paulsilvis/DustCollector/README.md

# DustCollector
restarting this project from scratch with new directory structure
