paulsilvis/DustCollector/obsidian-vault/To-Do List.md

(started 6/2/2025, since we're getting near the end)
	
	- ~~add the dust-level sensor for the collector bin to the doc~~
	- make that sensor and install it
	- make the rest of the blast gates
		- install the limit switches
	- fix the blast gate that's bent
	- install the remaining ductwork and blast gates
	- do the wiring
	- install the current sensors
	- ready the enclosure for wiring
		- mark and cut db-25 openings
		- make mounts for fuses
		- add reboot / shutdown switch
		- replace emergency shutoff switch
	- ~~have a beer~~
	- 
	-
