paulsilvis/DustCollector/docs/temp.md

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

<!-- vscode-markdown-toc-config
	numbering=true
	autoSave=true
	/vscode-markdown-toc-config -->
<!-- /vscode-markdown-toc -->

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

As  I  put  together  a  plan  for  salvaging  some  parts  of  the  original  collector  and  upgrading  my  filtering  capacity,  I  decided  that  it  would  be  really  _cool_  to  do  just  a  bit  more  automation,  and  have  the  blast  gates  operate  automatically  depending  on  what  tools  (e.g.,  tablesaw,  drillpress)  were  running.

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

###  1.1. Essential  Goals

So,  the  _essential_  goals  areh>:

-  Open  and  close  appropriate  blast  gates  automatically  when  any  powered  tool  is  running,  and  close  them  when  none  are  running.

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

-  The  entire  controller  must  fit  inside  a  wall-mounted  enclosure  with  a  clear  door  for  visibility.

###  1.2. Optional  Goals

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

##  2. The  Big  Picture  --  Physical  System
The  physical  system  consists  of:
-  the  recycled  impeller,  housing  and  motor  from  the  original  dust  collection  system.
-  a  'Dust  Deputy'  cyclone  to  direct  most  of  the  heavy  debris  downwards  to  ...
-  a  collection  bin  with  a  capacity  of  <tbc>  cubit  feet
-  a  heavy  duty  pleated  commercial  filter  rated  MERV  14  that  catches  particles  as  small  as  1.5  microns,  which  sits  atop...
-  a  removable  bucket  fastened  securely  to  it  that  holds  dust  released  from  cleaning  the  filter  by  banging  on  it  **gently**  while  dousing  it  with  **low-pressure**  compressed  air  from  the  outside.

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

The  [canister  filter](https://wynnenv.com/?s=13F230NANO+&post_type=product)  is  from  Wynn  Environmental,  and  costs  about  $230.  This  high-efficiency  filter  traps  over  95%  of  particles  sized  3.0-10.0  microns,  such  as  lint,  dust,  pollen,  pet  dander,  and  mold  spores,  as  well  as  particles  from  coughs,  sneezes,  and  smog.    Here's  a  [filter  rating  chart](https://www.mechreps.com/PDF/Merv_Rating_Chart.pdf)  to  give  you  more  information.

At  the  botom  of  the  filter  a  collection  bucket  is  attached  with  a  "gamma  seal"  lid  --  it  just  twists  off.

alt text

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

##  3. Project  Directory  Structure

        ├──  docs
        │    └──  images
        ├──  hardware
        ├──  notebooks
        ├──  obsidian-vault
        ├──  src
        │    ├──  dustcollector
        │    └──  hardware
        └──  tests

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

-  The  'notebooks'  directory  is  intended  for  [jupyter](https://jupyter.org/)  things  like  experiments,  informal  tests,  etc.

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

##  4. Software  Architecture

a picture

##  5. Key  Subsystems

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

The  main  tools  are:
-  the  table  saw
-  the  lathe
-  the  drill  press

Each  of  these  has  a  5-inch  duct  connecting  it  to  the  intake  of  the  dust  collector.    At  some  point  on  the  ductwork  leading  to  each  tool  there  is  a  blast  gate  that  controls  the  flow  of  air  into  the  dust  collector.

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

####  5.1.1. The  Distributor

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

[Yes,  this  is  excessive.    I  don't  care.    I  like  lots  of  switches  and  buttons.]

###  5.3. The  Current  Sense  Subsystem
The  'on'  or  'off'  state  of  a  given  power  tool  such  as  the  table  saw  is  determined  by  detecting  the  presence  or  absence  of  current  in  a  split-coil  transformer  wrapped  around  the  'hot'  line  going  to  the  saw.    This  is  connected  to  a  custom  circuit  on  the  controller  that  converts  the  0  -  100  mA  current  into  a  0-5V  signal  to  be  read  by  an  a/d  converter  and  converted  to  a  logic  value  meaning  'on'  or  'off'.

###  5.4. The  Gate  Control  Subsystem
The  gate  conrol  system  is  responsible  for  sensing  machine  state  (On  or  Off),  opening/closing  the  appropriate  blast  gate[s]  and  turning  on  (or  off)  the  dust  collector  impeller  motor.

Gate States

There  is  currently  a  provision  for  a  delay  before  turning  off  all  tools  and  turning  off  the  dust  collector  impeller  motor.    This  is  to  allow  any  remaining  dust  to  be  sucked  out  of  the  system.    It  may  turn  out  that  this  is  unnecessary  due  to  the  high  velocity  of  the  air  in  the  ducts  (estimated  to  be  over  80  MPH).

##  6. The  Top  Level  Software  Structure

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

[^Bob]:  This  is  the  name  I  gave  to  my  ChatGPT  agent.   We're  good  friends  now.]

##  7. Enclosure

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

##  8. The  Monitor  Subsystem

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

##  9. Wiring

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

1.  Length  considerations
2.  Connector  type  mismatches
3.  Connector  pin  assignments  don't  match.

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

A/C:
        Neutral  --  White  (referred  to  as  Gnd  on  the  board)
        Hot  --  Black
        Ground  --  Green.

D/C:
        5V  --  Orange
        3.3V  --  Black
        12V  --  Red
        Gnd  --  White

All  Ground  connections  are  tied  together  on  the  board.

____Remember  --  this  is  not  guaranteed!      Look  at  where  the  wires  go  to  be  sure.____

###  9.1. The Current Sense Circuit

This custom circuit board holds 4 identical circuits to convert a 0-100 mA current from a transformer into a small voltage that a 4-channel ADS1115 a/d converter can read.

<TBD> Need a circuit diagram here.

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

<TBD> Need a circuit diagram here.

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

#####  74HC595  Chaining  and  Bit-to-Pin  Mapping

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

#####  Critical  Fact  About  Chained  595s:

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

Thus:
-  byte1  →  chip2
-  byte2  →  chip1

Bit-to-Pin  Layout  (directly  from  the  code)

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

In  Practical  Summary:
---------------------
-  byte1  →  fills  chip2  (the  far  one)
-  byte2  →  fills  chip1  (the  near  one)
-  Pins  1-6  on  each  chip  will  reflect  bits  1-6  of  each  respective  byte.
-  MSB  (bit  7)  and  LSB  (bit  0)  could  be  unused  or  reserved.

Visual  Sketch:
--------------
SPI  -->  [byte2][byte1]
                  |            |
                  |            +-->  chip2  (pins  1-6)
                  +-------->  chip1  (pins  1-6)

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

**Final  Word:**

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

----------------------------------------

#####    The  Net  Result

This  organization  means  that  it  is  easy  to  spot  the  3  signals  need  for  each  motor.    Take  a  look  at  the  circuit  board  and  you'll  s        """ee  that  E(enable),  S(step)  and  D(dir)  are  grouped  for  each  motor.    Look  at  the  two  shift-register  chips.  For  chip  1  (left)  pins  1,  2  and  3  are  ESD  for  motor  4  (the  nearest  motor.  For  chip  2  (right)  pins  4,  5  and  6  are  ESD  for  Motor  1  (the  nearest  motor).    You  get  the  idea.  Cool.

##  10. Power  Supplies

I  decided  not  to  use  the  Raspberry  Pi  4b  plug-in  power  input  for  these  reasons:

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

-  [12V  supply]  (https://www.amazon.com/dp/B00M8TBJLK?ref_=ppx_hzsearch_conn_dt_b_fed_asin_title_6)  

        Description:  LRS-150-12  150W  12V  12.5  Amp  Enclosed  Switchable  Power  Supply  

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

##  11. Digital  I/O  Pin  Map

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

###  12.1. Stepper  Drivers

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

**Safe  VREF  Setup  Without  Motor  Connected  (Courtesy  of  Bob)**

**Purpose:**

        Prevents  the  chance  of  slamming  full  current  into  the  motor  during  first  power-up.

        Avoids  a  damaged  motor,  a  fried  driver,  or  accidental  runaway  heating.
        
**Steps:**

        Install  the  new  DRV8825  board,  BUT  DO  NOT  connect  the  motor  coils  yet.

                Leave  the  motor  wiring  unplugged.

                Only  connect  logic  (VDD,  GND,  STEP,  DIR,  ENABLE)  and  motor  power  (VMOT,  GND).

        Power  up  the  system  (logic  and  VMOT  live).

        Measure  VREF  at  the  trimpot  just  like  before:

                Black  multimeter  probe  to  GND.

                Red  probe  to  the  metal  top  of  the  potentiometer.

        Adjust  VREF  carefully:

                Clockwise  to  increase,  counterclockwise  to  decrease.

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

        Power  down  the  system.

        Connect  the  motor  coils  properly:

                Double-check  you  know  which  motor  wire  pairs  are  each  coil.

                (If  not  sure,  I  can  give  you  a  10-second  multimeter  method.)

        Power  back  up  and  test  the  motor  gently  (slow  step  pulses  first).

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

###  12.2. Power  Supplies

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

<TBD> MENTION THEM!

###  13.2. Coding

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

The style guide is:

- pycodestyle compliant
- flake8 compliant
- black -l 79 compliant

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

###  13.3. A Note on Using AI to Generate Code

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
