paulsilvis/DustCollector/docs/design-doc.odt

Dust Collector System

Design Document

This will add linear actuators (or maybe rotary servo motors) to new custom-made (or possibly commercial-off-the-shelf) blast gates, plus sensors to detect when a machine is turned on or off to control blast gates and the dust collector motor appropriately.

Disclaimer: I know that this whole thing could be done without a microprocessor by a clever hardware engineer who knew his trade. It would be cheaper by far, and cooler by an order of magnitude. I am not such a person, however, so I revert to my safe zone as a software engineer and crush this problem with a dedicated computer running a Python program on a Linux machine. So there.

# Be sure to check the ‘new ideas’ section at the end.

### Architecture

This picture is an overall view of the physical collection system:

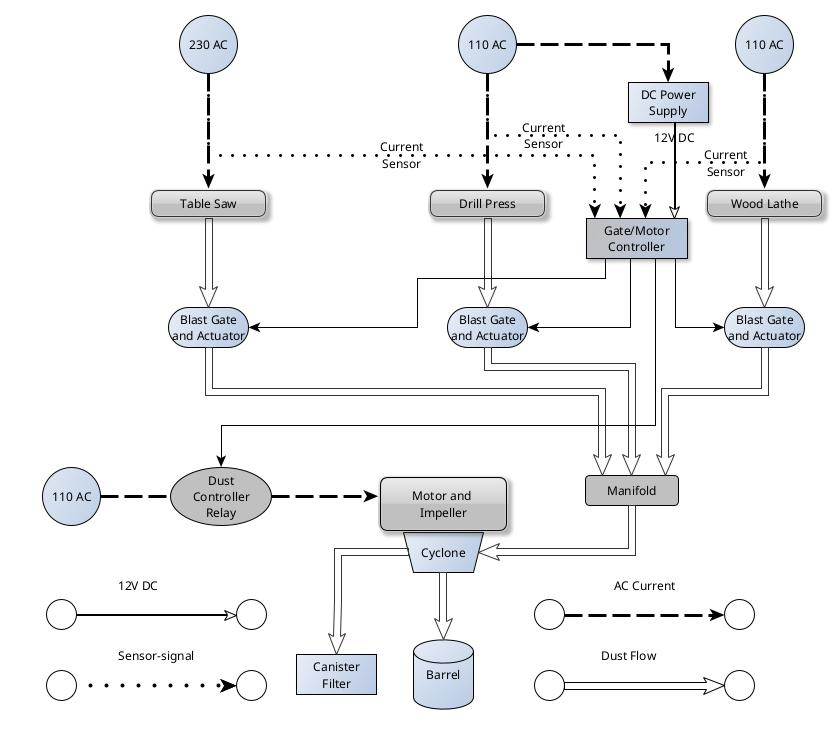
[picture p7: figure]
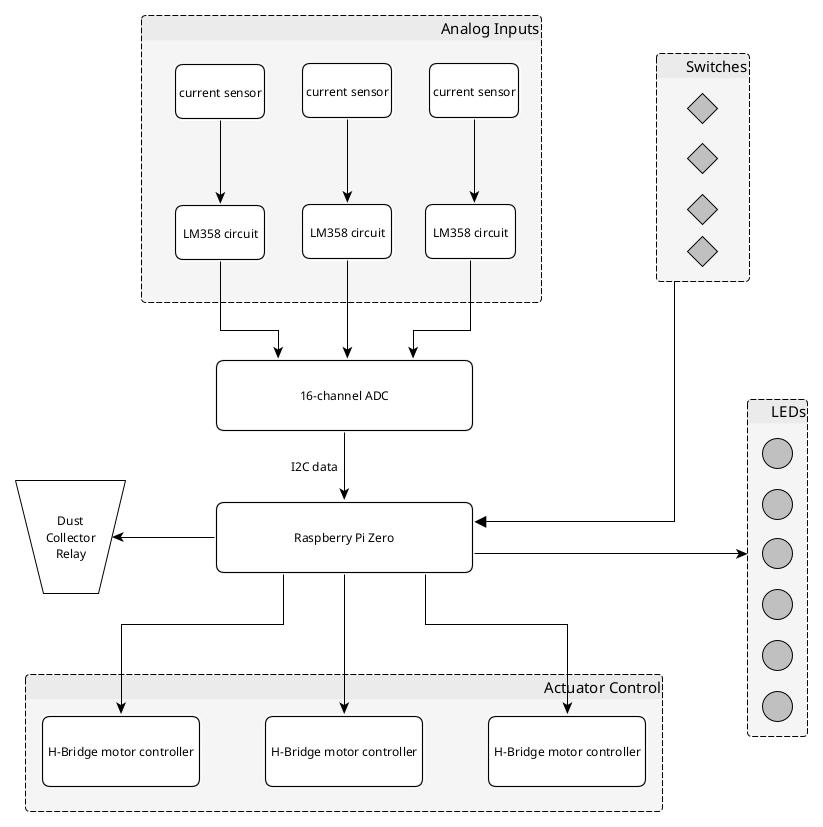
[picture p8: figure]

This is an overview of the hardware system (the controller itself):

# Gate/Motor Controller

This controller is implemented on a Raspberry pi zero, much like this one (https://www.adafruit.com/product/3708) by adafruit. I’ve got plenty of suitable wall-plug 5V supplies like this one (https://www.adafruit.com/product/1995) available, so one of them will do for power. It’s got more than enough GPIO for my needs. I’ll need an external A/D multi-channel converter such as this ADS1115 (https://how2electronics.com/how-to-use-ads1115-16-bit-adc-module-with-arduino/) for sensing current in the shop tools (saw, drill press and lathe power cords).

### Components

I have on order from Amazon:

1. A linear actuator that travels 4 inches in a couple of seconds, and has a 4.5 lb push, which should be more than enough. See this information (https://www.amazon.com/dp/B07ZJ46947?ref=ppx_yo2ov_dt_b_fed_asin_title&th=1).
2. A 12V power supply for the actuator. This one can handle power needs for all 3 gates. See this information (https://www.amazon.com/dp/B00M8TBJLK?ref=ppx_yo2ov_dt_b_fed_asin_title).
3. A current sensor module. See this information (https://www.amazon.com/dp/B0C6Y5MJNM?ref=ppx_yo2ov_dt_b_fed_asin_title).
4. A 40 Amp AC solid state relay to control power to the dust collector motor. See this information. (https://www.amazon.com/dp/B07L1MKFG6?ref=ppx_yo2ov_dt_b_fed_asin_title)
5. 1 pc. 47 Ohm resistor from Amazon (100)
6. 2 pcs. 10K Ohm resistors from Amazon (100)
7. LM358 op amp and block from Amazon (lots)
8. 16 bit 4- channel ADC from Amazon (https://www.amazon.com/gp/product/B0CNV9G4K1/ref=ox_sc_act_title_2?smid=A38CU2XC1RY0BO&psc=1) (3 pcs) (spec sheet here (https://www.ti.com/lit/ds/symlink/ads1115.pdf?ts=1736820696729)) There is a good library built for this -- see here (https://github.com/ncdcommunity/Raspberry_Pi_ADS1115_16Bit_4Channel_ADC_Python_Library/blob/master/ADS1115.py).
9. H-Bridge motor controller from Amazon (https://www.amazon.com/gp/product/B0C5JCF5RS/ref=ox_sc_act_title_1?smid=A2RFXKS6GNXFWP&psc=1) (4 pcs) (spec sheet here (https://www.handsontec.com/dataspecs/L298N%20Motor%20Driver.pdf)) Some usage notes: here (https://howtomechatronics.com/tutorials/arduino/arduino-dc-motor-control-tutorial-l298n-pwm-h-bridge/) (there may be confusion between different specs – be sure to follow the actual labels on the board)
10. I will soon order this canister filter (https://wynnenv.com/products-page/cyclone-filter-pricing/13r230nano/) that is MERV 15, Open Both Ends, 34" Tall, No Inner cage - Heavy duty outer cage. I have 84 inches of height to work with. If I stack two of them, that takes up 68 inches, leaving me with 16 inches to spare. That does not leave me room for both the inlet above and a bucket below. About $225
11. If I have a bucket below the filter for catching stuff, I need a gamma lid (https://www.amazon.com/s?k=gamma+lid). Here’s a link to a youtube video that shows how to mount it (https://youtu.be/HYTR24EQ8hI). About $12. (https://www.amazon.com/Oneida-Air-Systems-Super-Deputy/dp/B09WWM6X3F?mcid=15b9428ab17b326db8282fca8c1c037e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)
12. I will also order a Dust Deputy Cyclone (https://www.amazon.com/Oneida-Air-Systems-Super-Deputy/dp/B09WWM6X3F?mcid=15b9428ab17b326db8282fca8c1c037e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) from Amazon. About $180.

Items 5, 6 and 7 form a circuit to read the current signal coming from the current sensor (item 3).

Item 8 connects all 3 analog inputs from each of the converters made by 5-7 and convert them to digital.

Item 9 controls the linear actuators (reverse/forward)

### Basic Logic

The controller measures the current sensor on each machine. If there is current flowing (that is, the machine is on) then the blast gate for that machine is opened. [Since the actuator has limit switches at each end, it should OK to keep telling it to open. Otherwise some sort of state machine is in order.] In addition, the relay for the dust collector motor is activated, turning on the dust collector. [This too is an idempotent operation.] If a sensor indicates that the machine is not running (no current) then the corresponding blast gate is closed [again, idempotent]. If no machines are running, the dust collector relay is turned off, and the dust collector stops after a suitable delay (maybe 3 minutes or so? Maybe determined by dip switches? Or overridden by push-button?)

There may be a need to introduce a short delay between starting to open the blast gate and turning on the dust collector, since the actuator needs a couple of seconds to work. This is easy to do if it becomes necessary, but I don’t think it will – it takes the dust collector motor a couple of seconds to spin up anyways, and that’s about how long it takes the gate to open.

I should include some power-on logic in the program to move each output to a known safe state (gates closed, dust collector off) and wait for a second or two.

At this time I don’t see the need to provide micro-switches to detect open/closed gates, but that’s a possibility if I want to detect faults in the system such as a jammed gate or burned-out actuator or servo.

### Input and Outputs

#### Inputs

The 16-bit 4-channel ADC is an I2C device. The circuit diagram is shown below.

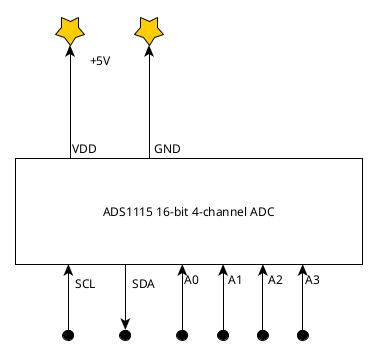
[picture p9: figure]

The input from the current sensors is an analog voltage I can read with the multi-channel A/D after running it through the LM358 circuit. The circuit below (from a youtube screenshot (https://youtu.be/tA5pcc-xyJg?t=98)) will measure current in the PCTZ-02.

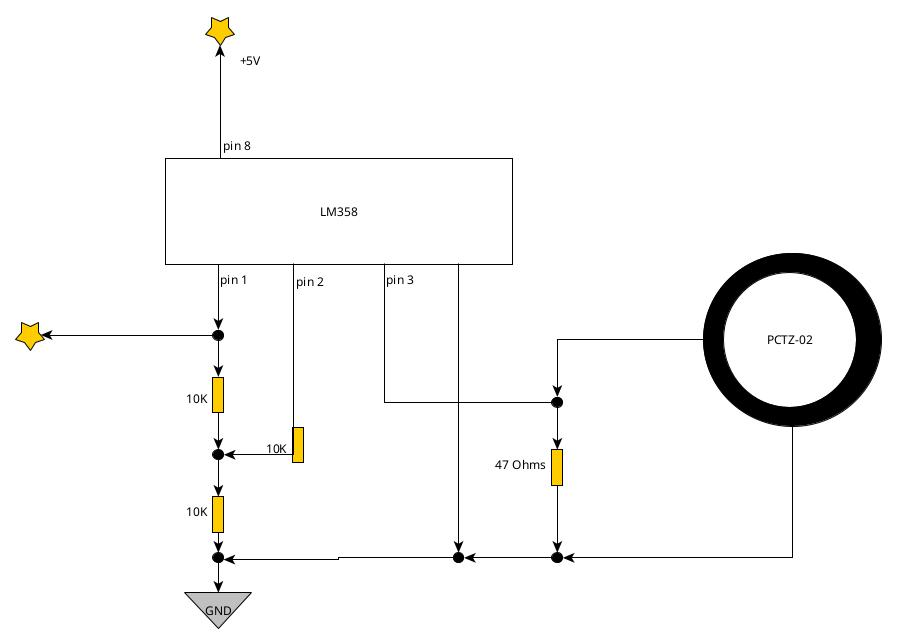
[picture p10: figure]

### Outputs

- Output to the actuators is just a 12-volt signal with polarity reversed to reverse the direction. Here’s a link to a ChatGPT discussion about H-bridges (https://chatgpt.com/share/6785ed26-9738-8001-8c28-717485e1faa6) to implement this.
- Output to the solid-state relay is simple.
- I might want to add some LED outputs to show status, just for coolness. For example, green for open, red for closed, similar for the motor.

### Hardware

There are many designs for blast gates, such as this one (https://www.etsy.com/listing/1199263512/blastgate-gate-valve-gate-valve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) for DIY, or this one (https://www.etsy.com/listing/1778996941/4-motorized-blast-door-for-dust?gpla=1&gao=1&gad_source=1) (which is really silly, because it would leak like a sieve) , or this beauty (https://www.etsy.com/listing/1684678449/dust-collection-blast-gate-clog-free?external=1&rec_type=ad&frs=1) (with free shipping – this is the best one I’ve seen.). Then there’s this plan (https://www.etsy.com/listing/1043535705/blast-gates-for-dust-extractor-svg-dxf?click_sum=d91ce4a6) for DIY – very cool. If the servo I just ordered doesn’t do the trick, this one surely will (https://www.amazon.com/ZOSKAY-DS3218-Digital-Waterproof-Control/dp/B01MU7TQV8).

### Testinghere

Just for coolness it would be neat to add a push-button that would initiate a sequence of events to verify correct operation. (There’s lots of great choices for momentary contact panel-mount push-buttons like these (https://www.amazon.com/DMWD-12-Pack-Momentary-Pre-soldered-PBS-110/dp/B0BHC5RXY1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). De-bouncing: look here (https://raspberrypi.stackexchange.com/questions/118349/what-is-the-proper-way-to-debounce-a-gpio-input) for a hardware solution, or here (https://hackaday.com/2010/11/09/debounce-code-one-post-to-rule-them-all/) for software solutions)

For example, one such sequence would be:

1. open gate 1, wait 5 seconds,
2. close gate 1, wait 5 seconds
3. same for gates 2 and 3
4. open all gates, wait for 5 seconds
5. close all gates, wait 5 seconds
6. open all gates, wait 5 seconds
7. turn on dust collector, wait 60 seconds
8. turn off dust collector
9. close all gates

… and so on.

### Online Resources

- measuring ac current with arduino (https://www.youtube.com/watch?v=tA5pcc-xyJg)

### Development methodology

Python is the language of choice here. ChatGPT can do a decent job of generating skeleton code given suitable prompts. I plan to develop separate Python apps for checking out each component.

- Current sensor input: a program to read the current sensor at 1 Hz or so and print out the value.
- Linear actuator: a program to move the actuator all the way out, wait 3 seconds, then all the way back, wait 3 seconds, and repeat.
- Solid-state relay: turn AC outlet on and off.
- Basic logic: a program that will exercise the logic of the controller by simulating inputs via a script. Doing this early on will make implementation of the logic easier.

## New Ideas

This guy (https://www.digikey.com/en/maker/projects/diy-dust-collection-automation-smart-blast-gates-with-home-assistant/6c950d28854840119afbce4b54b79a19) has a nice way of moving blast gates. So does this guy (http://www.shigshop.com/blast-gate-plans.html). The idea is to use a blast gate that pivots around a single point instead of sliding linearly. I’ve ordered 3 servo motors (https://www.amazon.com/dp/B0BKPL2Y21?smid=A1YZW40LYQY3L1&ref_=chk_typ_imgToDp&th=1) from Amazon that I’ll play with – this might be a more compact solution.

Also, I may need a small fan to keep air running over the processor board to keep it from overheating.

I may need a hardware switch to force each gate/collector control, if I want to just run the dust collector without having a machine on (to clear the air in the shop, for example). Also need to disable the controller from running its usual loop. Or, read both the current and the switch and ‘or’ them together?

This phenolic (https://www.amazon.com/Leecraft-BK-2-Blank-Phenolic-Sheet/dp/B0002898CQ?cv_ct_cx=phenolic+sheet+1%2F4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) would be good for blast gate material, housed in an MDF enclosure.

This sensor (https://www.amazon.com/dp/B091XXY98J?s=industrial&sp_csd=d2lkZ2V0TmFtZT1zcF9kZXRhaWw) may be a better choice for measuring the current. Code is here (https://www.electroniclinic.com/measure-current-with-arduino-split-core-current-transformer-ct/).

I had a good chat with ChatGPT about servos – the results are in the files “full_verbatim_servo_chat_final_corrected.pdf” and “servo_power_up_chat_cleaned.pdf”.

McMaster-Carr (https://www.mcmaster.com/products/blocks/material~polycarbonate/impact-resistant-polycarbonate-sheets/) is a good source of thick sheets of polycarbonate, Delrin and such for making mounting blocks for the servos to glue on to the gate housing. Will 15-minute J-B Weld hold Delrin? (answer: not very well)

### Wish List

1. Nice GUI touch display
  1. graphs showing history of particulate matter in the air
  2. animated gate states and blower states
  3. temp, humidity ambient
  4. temp/humidity inside enclosure
  5. temp of raspberry pi
  6. current time and date in different zones
  7. shopcam
  8. Foxnews

differential pressure sensor (https://www.aliexpress.us/item/3256802384784556.html?src=google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)

another one (https://www.aliexpress.us/item/3256802384784556.html?src=google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)

enclosure (https://www.amazon.com/KWONONG-Enclosure-Waterproof-Electrical-350×250×150mm/dp/B0BWR3LG6C?sbo=RZvfv%2F%2FHxDF%2BO5021pAnSA%3D%3D) or this (https://www.amazon.com/Otdorpatio-Waterproof-Electrical-Electronic-Enclosure/dp/B0D8JQPGSX?s=industrial) or this (https://www.amazon.com/QILIPSU-Waterproof-Electrical-Enclosure-Weatherproof/dp/B0C99F7Q5X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)

this will also work (https://www.amazon.com/QILIPSU-Waterproof-Electrical-Enclosure-Weatherproof/dp/B0C99F7Q5X?s=industrial)

shopcam! (https://www.instructables.com/How-to-Make-Raspberry-Pi-Webcam-Server-and-Stream-/)
