paulsilvis/DustCollector/docs/development-notes.odt

Notes on Development

## Miscellaneous

1. Clean up the office so I can get at the embedded system development stuff.
2. Get that out and inventory it to see if I’ve already got a Raspberry pi that will suffice.
3. If so, use it, if not, get one.
4. Learn how to use its wireless capability
5. Clean up the shop so I can use the end of the workbench as a work area for laptop and Raspberry pi development.
6. I checked out the linear actuator, should have no problem using that, although servo operation will be cooler with a wedge gate.
7. Wow – maybe I could use a Raspberry Pi pico W. This shit is incredible.
8. Fan for ambient filter: https://www.amazon.com/Air-King-9723-20-Inch-3-Speed/dp/B0007Q3RMA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
9. filter for ambient filter:https://www.amazon.com/Nordic-Pure-20x20x1-Pleated-20x20x1M14-6/dp/B007KPY8DI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
10. improve performance of corsi-rosenthal filter: https://www.texairfilters.com/how-to-improve-the-efficiency-of-the-box-fan-and-merv-13-filter-air-cleaner/
11. another, more powerful fan: https://www.amazon.com/dp/B000GGNTU6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 (https://www.amazon.com/dp/B000GGNTU6?s=home-garden&sp_csd=d2lkZ2V0TmFtZT1zcF9kZXRhaWxfdGhlbWF0aWM)
12. particulate matter sensor: https://www.amazon.com/dp/B08DP2HBPN (very cool)
13. standoffs for mounting: https://www.amazon.com/dp/B0CBPGKDP4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 (https://www.amazon.com/dp/B0CBPGKDP4?s=industrial&sp_csd=d2lkZ2V0TmFtZT1zcF9kZXRhaWw)
14. breakout board for rpi: https://www.amazon.com/Status-Terminal-Block-Breakout-Raspberry/dp/B08RDYDG6X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
15. case for rpi?: https://datasheets.raspberrypi.com/case/case-for-raspberry-pi-5-product-brief.pdf
16. rpi4 case?: https://www.amazon.com/Miuzei-Raspberry-HDMI-Micro-Aluminum-Included/dp/B07VX2WDHM
17. hdmi mountable connector: https://www.amazon.com/Toronce-Panel-Mount-Connector-D-HDMI-Through/dp/B092W917NG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
18. mountable usb port: https://www.amazon.com/BATIGE-Square-Extension-Motorcycle-Dashboard/dp/B0BDWV1BCV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
