paulsilvis/DustCollector/docs/interfaces.odt

This document lists the various interfaces and provides some detail about them.

## Break Beam Interface

This is pretty simple. (https://www.amazon.com/dp/B00XW2NVJU?ref=ppx_yo2ov_dt_b_fed_asin_title) (but won’t work for me…) This one is better and is on order. (https://www.amazon.com/dp/B09L63KPZS?psc=1&smid=A3HMB6GLG0WJ17&ref_=chk_typ_imgToDp) datasheet here (https://www.ett.co.th/productSensor/E3F-5DP1-5L/Manual%20of%20Photo-SensorSW%20M18-E3F.pdf)

## PIR Sensor Interface

<tbd>

## Switch Interface

This will probably use a digital mux like this. (https://www.amazon.com/gp/product/B07P2H1NZG/ref=ppx_yo_dt_b_asin_title_o02_s00?ie=UTF8&psc=1) Datasheet here. (https://www.waveshare.com/wiki/MCP23017_IO_Expansion_Board)

## Multichannel ADC Interface

This will make things easier. (https://www.amazon.com/gp/product/B0CNV9G4K1/ref=ppx_yo_dt_b_search_asin_title?ie=UTF8&psc=1) Datasheet here. (https://cdn-shop.adafruit.com/datasheets/ads1115.pdf)

## Servo Driver Interface

The servo driver controls 4 gates using this PWM multiplexer board. (https://www.amazon.com/gp/product/B07BRS249H/ref=ppx_yo_dt_b_search_asin_title?ie=UTF8&psc=1) Datasheet and tutorial here. (https://cdn-learn.adafruit.com/downloads/pdf/16-channel-pwm-servo-driver.pdf)

## Current Sensor Interface

This amplifier uses an LM358 op-amp (https://www.amazon.com/gp/product/B07Z6HRTGS/ref=ppx_yo_dt_b_search_asin_title?ie=UTF8&psc=1)to condition the signal from a PZCT-02 split-core current sensor (https://www.amazon.com/gp/product/B0C6Y5MJNM/ref=ppx_yo_dt_b_search_asin_title?ie=UTF8&psc=1) so it can be read by an ADC. There are 4 sensors, one for each machine. Design doc has more hints

## Light Control Relay

This is a Solid State Relay, requiring 1 signal pin and 1 ground connection. >+3 V turns relay on

## Motor Control Relay

This is a Solid State Relay, requiring 1 signal pin and 1 ground connection. >+3 V turns relay on

## LED Multiplexer Interface

The LEDs themselves are these. (https://www.amazon.com/dp/B077XGF3YR?ref=ppx_yo2ov_dt_b_fed_asin_title) These will probably be controlled by a digital mux like this. (https://www.amazon.com/gp/product/B07P2H1NZG/ref=ppx_yo_dt_b_asin_title_o02_s00?ie=UTF8&psc=1) See switch interface for datasheet. Also, see this chat for code samples. (https://chatgpt.com/share/679826be-c48c-8001-a7b9-7d51ef70574e)

OK – time for a short brain dump on how to go about this. There’s a long laundry list of physical hardware things to do – this will concentrate on how to go about writing the code and getting this thing running.

I. Strategy
  A. Create 3 directoriies
    1. for prototype code,
    2. one for test code
    3. one for mockup code
  B. Populate each directory with 1 program for each interface
    1. Get the prototype code working for an API
    2. Refine it into a test
    3. Make a mockup with the same interface
  C. Document each interface with the pins being used. It’s OK to do this in the code comments.
  D. Make a separate document listing all I/O pins and their connections.
II. Use these online references:
  A. Raspberry pi 4 pinout chart (https://www.tomshardware.com/reviews/raspberry-pi-gpio-pinout,6122.html)
  B. Docstring conventions (https://campbell-muscle-lab.github.io/howtos_Python/pages/documentation/best_practices/best_practices.html)
  C. Chat about Jupyter, pytest, pydoc, etc. (https://chatgpt.com/share/679bb13e-f464-8001-ae5a-c8d851dc08a3)
  D. remember to try flake8
  E. measuring pressure! https://www.mouser.com/ds/2/315/ADE8000C41-944424.pdf
  F. or https://www.nxp.com/docs/en/data-sheet/MPXV6115V.pdf
  H. temperature and humidity! https://www.digikey.com/en/htmldatasheets/production/5750909/0/0/1/4566
  I. PYQT: https://raspberrytips.com/pyqt-on-raspberry-pi/
  J. raspberry pi AI https://www.raspberrypi.com/documentation/accessories/ai-kit.html
  K. python gui with tkinter: https://www.youtube.com/watch?v=epDKamC-V-8
  L. gui generation with drag/drop figma: https://www.youtube.com/watch?v=NVPibVfFVtM
  M. custom tkinter: https://www.youtube.com/watch?v=iM3kjbbKHQU
  O. Rsync and code transfer (https://www.youtube.com/watch?v=Nm_8u44zClw)
  P. This chat about development tools (https://chatgpt.com/share/679bb13e-f464-8001-ae5a-c8d851dc08a3)
  Q. Rsync (https://www.digitalocean.com/community/tutorials/how-to-use-rsync-to-sync-local-and-remote-directories) and syncthing (https://syncthing.net/)
  R. Here’s a chat about using ABC and abstractmethod for mockups (https://chatgpt.com/share/67a16bd5-3920-8001-ae42-d05d861710be)
  S. cable glands (https://www.amazon.com/RTHIEAI-Joints-Gaskets-Adjustable-Waterproof/dp/B0CNPHQ6L4?hvadid=630952643966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)
  T. led strips (https://core-electronics.com.au/guides/fully-addressable-rgb-raspberry-pi/)
  U. din connectors (https://www.amazon.com/GUETNEU-Terminal-Block-Voltage-Combined/dp/B0BQQDWGXV)
