paulsilvis/DustCollector/docs/revised-description.odt

Certainly! Here's a revised version of your original proposal with the additional clarifications and updates incorporated:

### Description of Dust Collection System

1. System Overview: The dust collection system consists of:
  - A Blower to move air containing dust.
  - A Cyclone Separator to remove heavier material into a bin.
  - A Filter to remove fine dust from the air before recycling it back into the room.
  - A Duct Network to guide air from various machines to the blower.
  - Machines connected to the system, each with a corresponding actuator and sensor.
2. Actuators: Each machine has an Actuator (either a LinearActuator or a ServoActuator) to control the blast gate associated with it.
  - ON: Opens the blast gate, allowing air to flow.
  - OFF: Closes the blast gate, stopping airflow.
  - The type of actuator used can be adjusted as needed, though physical changes to the setup require about an hour of effort.
3. Sensors: Each machine has a Sensor that monitors whether the machine is ON or OFF.
  - Sensors detect the machine’s current draw, updating their state approximately 10 times per second (10 Hz).
  - Debouncing is handled at the hardware level to ensure reliable readings.
4. Manual Controls:
  - Each gate has a Manual Mode Toggle Switch:
    - ON (Manual): Overrides the sensor value with input from a separate ON/OFF switch for that gate.
    - OFF (Auto): Uses the actual sensor value to control the actuator.
  - LED Indicators:
    - RED: Manual mode is active.
    - GREEN: Auto mode is active.
5. System Operation:
  - When a Machine Turns ON:
    - The corresponding blast gate is opened, and the blower is turned ON via a solid-state relay.
  - When a Machine Turns OFF:
    - A 30-second timer starts for that gate to flush dust from the duct.
    - If another machine is still ON or has its own timer running, the blower remains ON.
    - When all machines are OFF and their timers have expired, all gates are closed, and the blower is turned OFF.
6. Startup Behavior:
  - On startup, the system:
    - Turns OFF the blower and all actuators.
    - Waits 3 seconds before resuming normal operation.
  - If any machines are already ON during startup, the system treats them as “just turned on” and begins normal operation, including opening gates and starting the blower as needed.
7. User Notifications:
  - Simple, brief log messages to STDOUT provide feedback on system state changes (e.g., blower ON/OFF, gates opening/closing).
8. Timeout Value:
  - The 30-second timer for flushing dust is a global value. If changes are needed, it can be updated in the code.
9. System Scale:
  - The system is designed for up to 5 machines, suitable for a one-man shop. The current machines include:
    - Machine1: Table saw
    - Machine2: Drill press
    - Machine3: Lathe
    - Machine4: Router

This revised version integrates your answers and preferences, ensuring it reflects the complete and updated system design. Let me know if further refinements are needed!
