paulsilvis/DustCollector/docs/revised-revised-description.odt

Thanks for checking in! Everything seems to be fine now, and I’m glad to assist you. Let’s focus on incorporating asyncio into the updated design, with the actuator managing the blast gate and other components working together seamlessly.

### Refined Object-Oriented Design with asyncio

#### Key Considerations for asyncio Integration

1. Concurrency:
  - The system must handle multiple tasks concurrently, such as:
    - Periodically reading sensor states.
    - Monitoring and controlling actuators.
    - Managing timers for gate operations.
    - Controlling the blower based on system state.
  - asyncio allows you to run these tasks concurrently with non-blocking operations.
2. Event-Driven Design:
  - Use asyncio Event objects to signal state changes (e.g., a sensor detects a machine turning on).
  - Each actuator operates independently, reacting to events relevant to its corresponding machine.
3. Timers:
  - asyncio provides asyncio.sleep to implement non-blocking delays for the 30-second flush timer.

### Updated Class Design

#### 1. Actuator

- Manages the physical state of the gate.
- Runs an asynchronous coroutine to handle state changes.

class Actuator:

def __init__(self, name: str):

self.name = name

self.position = "CLOSED" # OPEN or CLOSED

self.manual_mode = False # True if manual override is active

self.event = asyncio.Event() # Triggers state changes

async def open(self):

self.position = "OPEN"

print(f"{self.name}: Gate opened")

async def close(self):

self.position = "CLOSED"

print(f"{self.name}: Gate closed")

async def monitor(self):

"""Coroutine to respond to events and handle manual mode."""

while True:

await self.event.wait() # Wait for an event

self.event.clear()

if self.manual_mode:

print(f"{self.name}: In manual mode, ignoring auto control.")

else:

# Open or close based on external state

print(f"{self.name}: Automatic control engaged.")

#### 2. Sensor

- Monitors the machine’s power state and triggers the actuator.

class Sensor:

def __init__(self, machine_name: str):

self.machine_name = machine_name

self.state = False # ON or OFF

async def read_state(self):

"""Simulate reading the machine's state periodically."""

while True:

# Replace with actual hardware interaction

new_state = ... # Read current

if new_state != self.state:

self.state = new_state

print(f"{self.machine_name}: State changed to {'ON' if new_state else 'OFF'}")

await asyncio.sleep(0.1)

#### 3. Controller

- Orchestrates the system, including managing timers, monitoring sensors, and controlling the blower.

class Controller:

def __init__(self):

self.actuators = []

self.sensors = []

self.blower_on = False

def add_machine(self, actuator: Actuator, sensor: Sensor):

self.actuators.append(actuator)

self.sensors.append(sensor)

async def control_blower(self):

"""Manage blower state based on active machines."""

while True:

if any(sensor.state for sensor in self.sensors):

if not self.blower_on:

self.blower_on = True

print("Blower turned ON")

else:

if self.blower_on:

self.blower_on = False

print("Blower turned OFF")

await asyncio.sleep(0.5) # Adjust as needed

#### 4. Main Event Loop

The asyncio.run function will manage the main loop, combining all tasks.

async def main():

controller = Controller()

# Create actuators and sensors for machines

actuator1 = Actuator("Table Saw")

sensor1 = Sensor("Table Saw")

controller.add_machine(actuator1, sensor1)

# Start tasks for sensors and actuators

await asyncio.gather(

actuator1.monitor(),

sensor1.read_state(),

controller.control_blower()

)

asyncio.run(main())

### How This Design Works

1. Concurrent Tasks:
  - Each actuator and sensor runs independently, reacting to events in real-time.
  - The controller orchestrates the overall system state.
2. Event-Driven Logic:
  - The Event objects in actuators allow precise control of when and how gates operate.
3. Scalability:
  - Adding more machines is straightforward—create additional Actuator and Sensor instances and register them with the controller.

Would you like me to expand on any part of this, or assist with building a specific piece of the code?
