paulsilvis/DustCollector/docs/uml-diagram.pdf

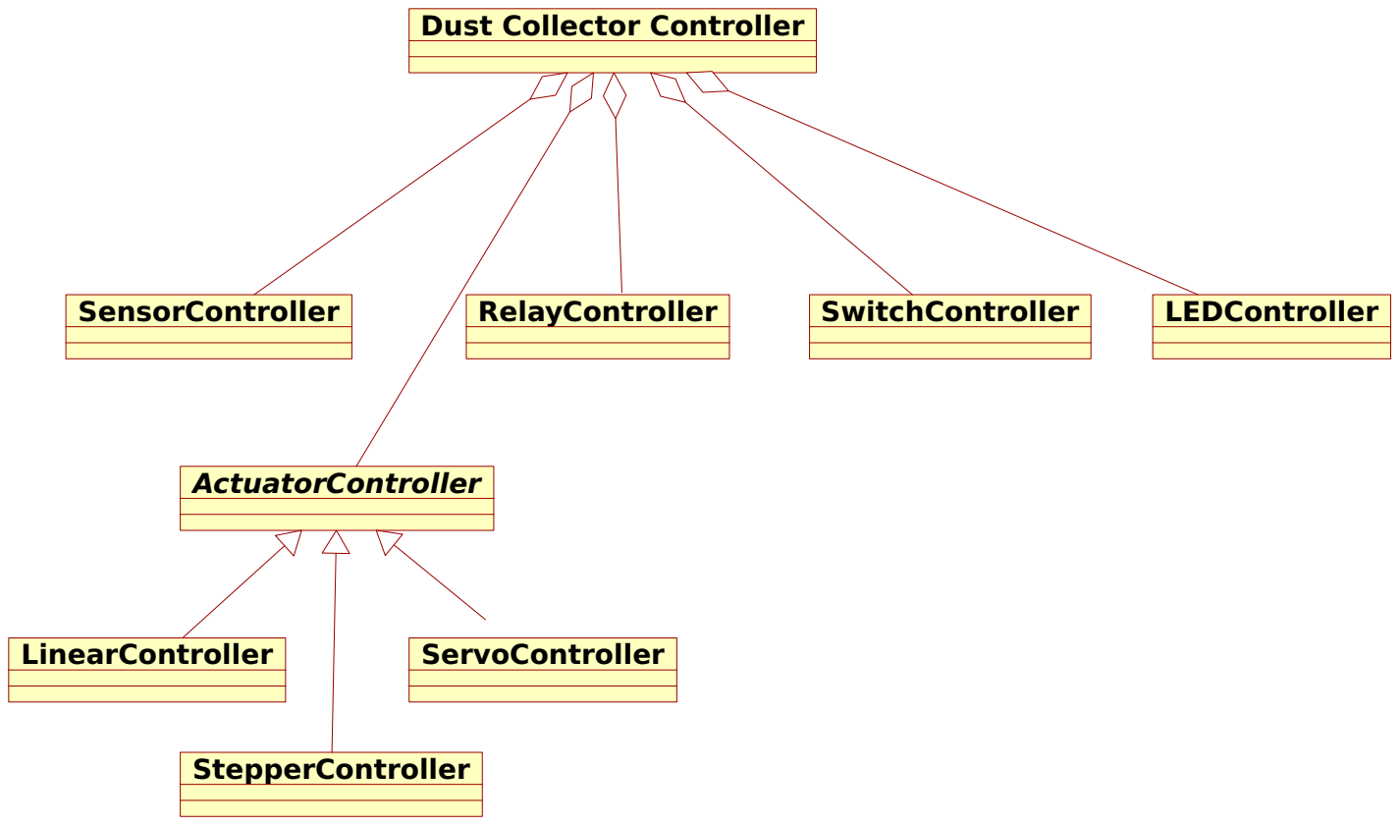
[picture p11: figure]
Dust Collector Controller; SensorController; ActuatorController; RelayController; SwitchController; LEDController; LinearController; ServoController; StepperController

Diagram: class diagram Page 1
