paulsilvis/DustCollector/docs/class diagram.png

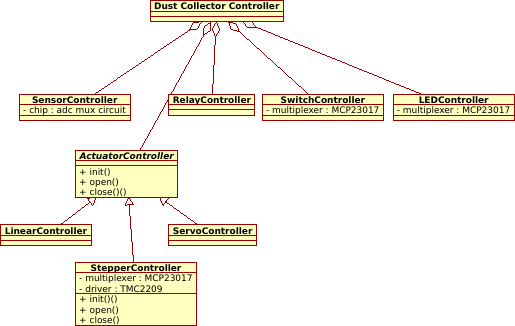
docs/class diagram.png
