paulsilvis/DustCollector/docs/current-sense.png

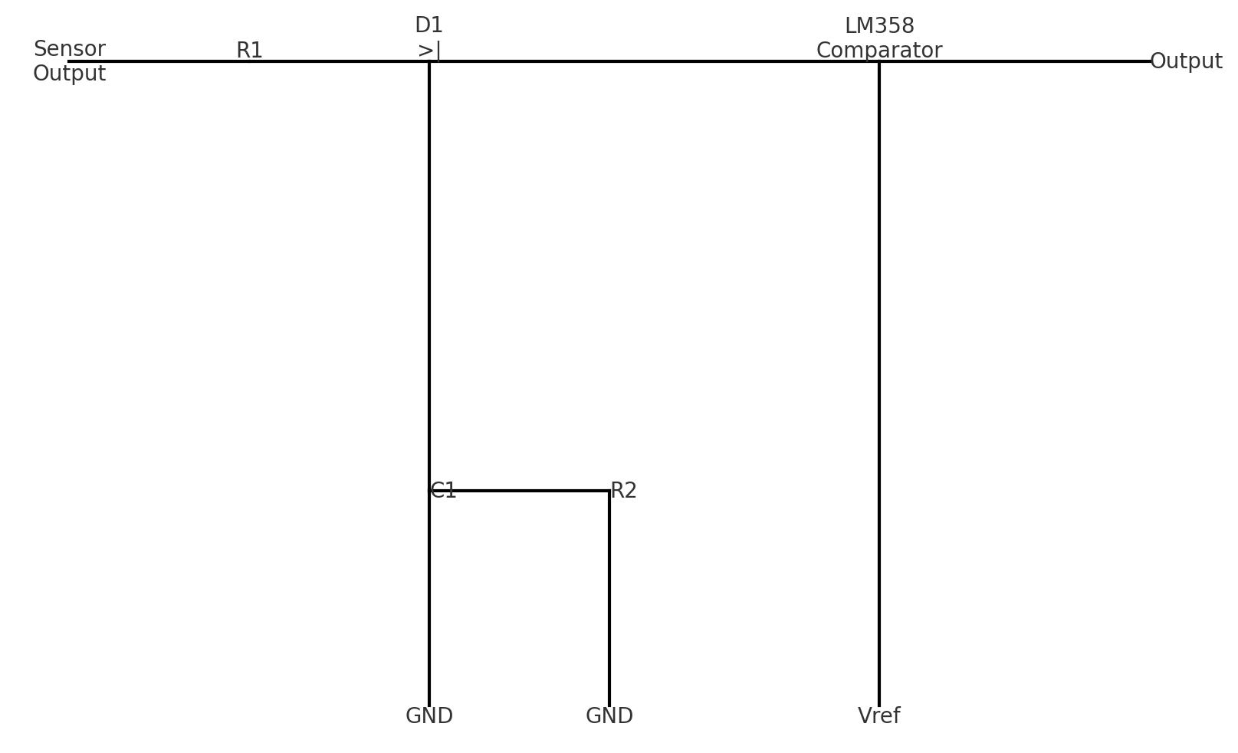
docs/current-sense.png
