paulsilvis/DustCollector/docs/Pasted image.png

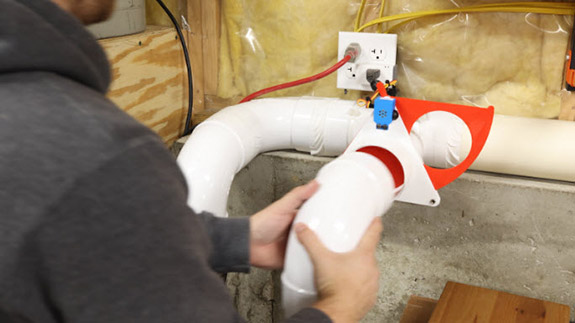
docs/Pasted image.png
