paulsilvis/DustCollector/docs/physical-layout.jpg

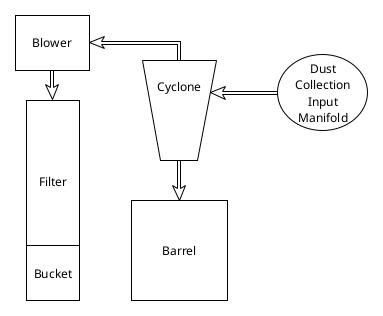
docs/physical-layout.jpg
