paulsilvis/DustCollector/docs/ordered-task-list.odt

Approximate order of events as of 3 February 2025:

1. Get hinges and latches at Lowe’s, along with metal strapping
2. Mount hinges and latches on C-R filter
3. Mount C-R filter
4. Make lid for 30 gallon barrel
  1. cut circle
  2. rout to fit
  3. finish with polyurethane
  4. ~~Mount cyclone on lid, seal I~~
5. Make boxes for PIR sensors
  1. mount Diodes in box
  2. mount box to joist
  3. run cable to wall
  4. repeat for other PIRs
  5. mount SSR on wall
  6. connect cables
  7. adjust and test
6. Make a decision on blast gates
  1. either design and make them, or
  2. buy steel ones.  Note – if I buy them, I may well have to rework each one to ensure that they work smoothly and without unacceptable leakage. If I make them, it will take time and effort, and I may still end up with gates that don’t work well. I will also need the right nuts, bolts and washers to make this happen. Make a decision and run with it.
7. Work on the electronics for blast gates:
  1. develop mounting system for servo
  2. prototype blast gate servo operation
  3. figure out calibration procedure.
  4. Verify current limit
8. Work on electronics for current sensing
  1. simple bench prototype for op-amp circuit check
  2. install loop in saw outlet, run wires for 20 ft
  3. verify operation
9. work on electronics for light control
  1. check circuit for break sensor
  2. mount break sensor
  3. locate, test and mount PIR sensors
  4. run wires to central location
10. pull the dust collector out
11. clean up back there with the vac
12. remove the fan and motor assembly
13. take some accurate measurements
14. get rid of the cart (save the bottom, and possibly the casters
15. figure out how and where to mount it
16. drill holes for anchors and install anchors
17. mount the fan and motor assembly
18. add 6” hose from fan to cyclone
19. add 6” hose from fan to cyclone
20. attach filter/bucket assembly
21. remove old 4” ductwork
22. start installing new 5” ductwork. NOTE – be very careful and
  1. begin with the saw, working backwards to the dust collector
  2. stub off the router
  3. add the lathe
  4. stub off the grinder
  5. add the drill press
