paulsilvis/DustCollector/docs/distributor_wiring.odt

Motor IDs are Motor1, Motor2, Motor3 and Motor4.

[Note – consider Motor 1 and Motor1 to be the same, and Chip 1 and Chip1 to be the same, and so on. Speak up if this is not clear.]

Physically, the Distributor has two 74HC595 chips, Chip1 and Chip2. The vero board on which these sit is positioned in the middle of a larger square that has 4 DRV8825 carries mounted on it. The upper left corner is Motor 4, lower left is Motor 3, lower right is Motor 2, and upper right is Motor 1.

Chip1 is the first chip in the shift-register chain, Chip2 gets its overflow. Note that this is probably not what you were assuming earlier, so start fresh with this. The chips are physically mounted on the vero-board so that chip 2 (on the right) controls motors 1 (top) and 2 (bottom) ) and chip 1 (on the left) controls motors 4 (top) and 3 (bottom).

Chip 1 is mounted with pin 1 at the top left facing motors 4 and 3, the pins are very close to their destinations and in exactly the right order starting from motor 4 (pins 1-3) and motor 3 (pins 4-6).

Chip 2 is mounted upside down, (that is, rotated 180 degrees) so that pin 1 is in the lower right-hand corner, and pins 1-3 will feed motor 2, while 4-6 feed motor 1.

So the bits (not pins) in a 16-bit word are:

high byte: [ 7, 6, 5, 4, 3, 2, 1, 0] (Chip 2)

low byte: [ 7, 6, 5, 4, 3, 2, 1, 0] (Chip 1]

The high order byte is sent first, msb first.

The bit 15-8 of the 16-bit word (high order byte (7-0) is sent first, so it ends up in Chip 2 as:

bit 15 (bit 7 of high-order byte) to pin1 7 of chip2 (NOT USED),

bit 14 (bit 6 of high order byte) to pin 6,

bit 13 (bit 5 of high order byte) to pin 5,

bit 12 (bit 4 of high order byte) to pin 4,

bit 11 (bit 3 of high order byte) to pin 3,

bit 10 (bit 2 of high order byte) to pin 2,

bit 9 (bit 1 of high order byte) to pin 1,

bit 8 (bit 0 of high order byte) to pin 15 of chip 2 (NOT USED)

Similarly, bits 7-0 of the low-order byte (sent second) end up in Chip 1 as:

bit 7 (bit 7 of low-order byte) to pin1 7 of chip1 (NOT USED),

bit 6 (bit 6 of low order byte) to pin 6,

bit 5 (bit 5 of low order byte) to pin 5,

bit 4 (bit 4 of low order byte) to pin 4,

bit 3 (bit 3 of low order byte) to pin 3,

bit 2 (bit 2 of low order byte) to pin 2,

bit 1 (bit 1 of low order byte) to pin 1,

bit 0 (bit 0 of low order byte) to pin 15 of chip 1 (NOT USED)

Motor 1:

Enable = Chip 2, pin 6

Step = Chip2, pin 5

Dir = Chip2, pin 4

Motor 2:

Enable = Chip 2, pin3

Step = Chip2, pin 2

Dir = Chip2, pin 1

Motor 3:

Enable = Chip 1, pin 3

Step = Chip1, pin 2

Dir = Chip1, pin 1

Motor 4:

Enable = Chip 1, pin 6

Step = Chip1, pin 5

Dir = Chip1, pin 4

trying again ….

Motor IDs are Motor1, Motor2, Motor3 and Motor4.

[Note – consider Motor 1 and Motor1 to be the same, and Chip 1 and Chip1 to be the same, and so on. Speak up if this is not clear.]

Physically, the Distributor has two 74HC595 chips, Chip1 and Chip2. The vero-board on which these sit is positioned in the middle of a larger clear acrylic square that has 4 DRV8825 carries mounted on it. The upper left corner is Motor 4, lower left is Motor 3, lower right is Motor 2, and upper right is Motor 1.

Chip2 is the first chip in the shift-register chain. Chip1 gets its overflow. The chips are physically mounted on the vero-board so that Chip 2 (on the LEFT) controls motors 4 (top) and 3 (bottom) ) and Chip 1 (on the RIGHT) controls motors 2 (bottom) and 1 (top).

Chip 2 is mounted with pin 1 at the top left facing motors 4 and 3, so the pins are very close to their destinations and in exactly the right order starting from motor 4 (pins 1-3) (bits 1-3) and motor 3 (pins 4-6) (bits 4-6).

Chip 1 (on the right) is mounted upside down, (that is, rotated 180 degrees) so that pin 1 is in the lower right-hand corner, and pins 1-3 will feed motor 2 (bits 1-3), while pins 4-6 (bits 4-6) feed motor 1.

This is an attempt to avoid confusion between bit number and pin numbering on the 74HC595.

So the bits (not pins) in a 16-bit word are:

595 PIN: [ 7, 6, 5, 4, 3, 2, 1, 15]

high byte: [ 15, 14, 13, 12, 11, 10, 9, 8] (Chip 1 on the RIGHT)

meaning: [ X D S E D S E X]

Motor 1 Motor 2

low byte: [ 7, 6, 5, 4, 3, 2, 1, 0] (Chip 2] on the LEFT)

meaning: [ X D S E D S E X]

Motor 4 Motor 3

The high order byte is sent first, msb first and ends up as bit 0 of chip 2 (on pin 1).

Note that this makes the correspondence between pins and signal easy to wire up and see.

REMEMBER: The high byte (sent first) goes to Chip1 on the right, which is rotated 180°.
The low byte (sent second) goes to Chip2 on the left, which is mounted upright.
Pin numbers (1–7) count from MSB downward (7 → 0), but because of chip orientation, they physically align left-to-right across both chips.

On the LEFT, the pins are:

1, 2 and 3 for Enable, Step and Dir on Motor 4.

4, 5 and 6 for Enable, Step and Dir on Motor 3.

On the right the pins are:

1, 2 and 3 for Enable, Step and Dir on Motor 2

4, 5 and 6 for Enable, Step and Dir on Motor 1

Note again the pins count down on the left chip (2), and up on the right chip (1), but in the same order – 1 through 6.

Bits 15-8 of the 16-bit word (high order byte (7-0) ) are sent first, so they end up in Chip 1 (on the right) as:

bit 15 (bit 7 of high-order byte) to pin 7, (NOT USED),

bit 14 (bit 6 of high order byte) to pin 6, (motor 1 dir)

bit 13 (bit 5 of high order byte) to pin 5, (motor 1 step)

bit 12 (bit 4 of high order byte) to pin 4, (motor 1 enable)

bit 11 (bit 3 of high order byte) to pin 3. (motor 2 dir)

bit 10 (bit 2 of high order byte) to pin 2, (motor 2 step)

bit 9 (bit 1 of high order byte) to pin 1, (motor 2 enable)

bit 8 (bit 0 of high order byte) to pin 15 (NOT USED)

Similarly, bits 7-0 of the low-order byte (sent second) end up in Chip 2 (on the left) as:

bit 7 (bit 7 of low-order byte) to pin 7. (NOT USED),

bit 6 (bit 6 of low order byte) to pin 6. (motor 4 dir)

bit 5 (bit 5 of low order byte) to pin 5, (motor 4 step)

bit 4 (bit 4 of low order byte) to pin 4, (motor 4 enable

bit 3 (bit 3 of low order byte) to pin 3, (motor 3 dir)

bit 2 (bit 2 of low order byte) to pin 2, (motor 3 step)

bit 1 (bit 1 of low order byte) to pin 1, (motor 3 enable)

bit 0 (bit 0 of low order byte) to pin 15. (NOT USED))

This leads to a motor map that looks like this:

Bit layout is based on physical pin mapping:

- High byte (bits 15–8) → Chip1 (upright) [motors 4 and 3)

- Low byte (bits 7–0) → Chip2 (rotated 180 degrees) [motors 1 and 2)

- Data sent MSB first (bit 15 down to bit 0)

"""

MOTOR_MAP = {

1: {'en': 12, 'step': 13, 'dir': 14},

2: {'en': 9, 'step': 10, 'dir': 11},

3: {'en': 1, 'step': 2, 'dir': 3},

4: {'en': 4, 'step': 5, 'dir': 6},

}
