paulsilvis/DustCollector/docs/Blast Gates - Plans.pdf

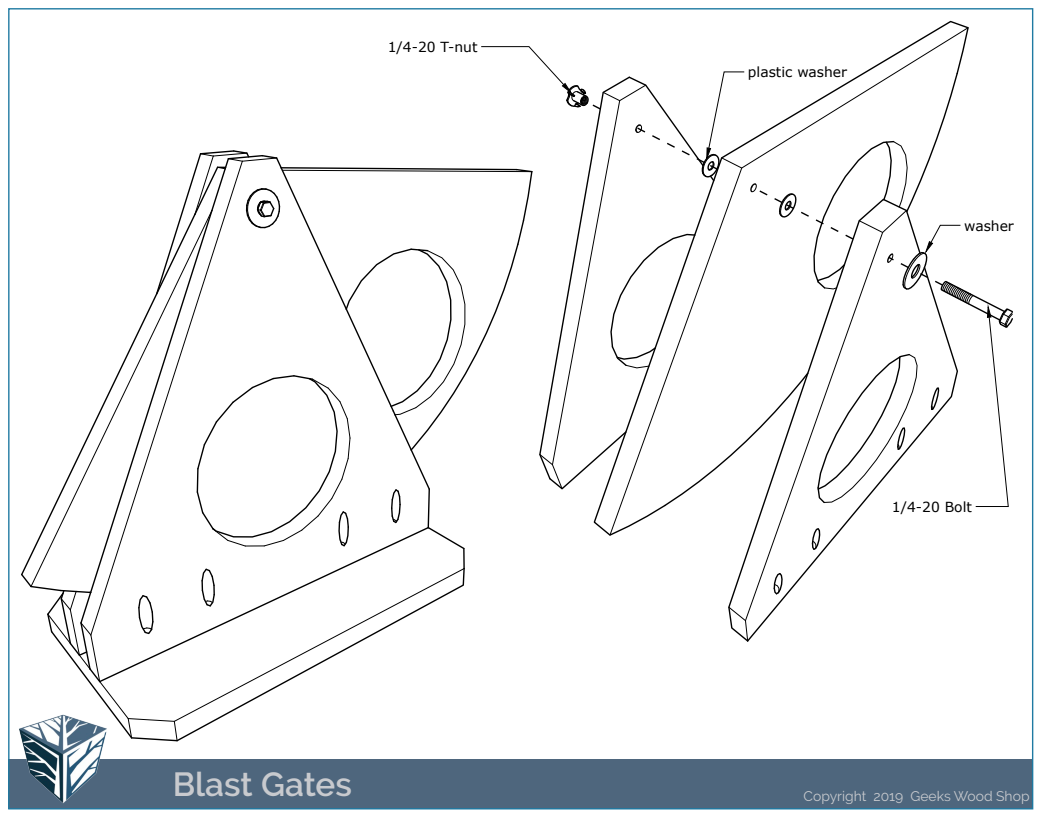
[picture p16: page 1]
Blast Gates; Copyright 2019 Geeks Wood Shop; 1/4-20 T-nut; plastic washer; 1/4-20 Bolt; washer

# 4” Gates 2 1/2"

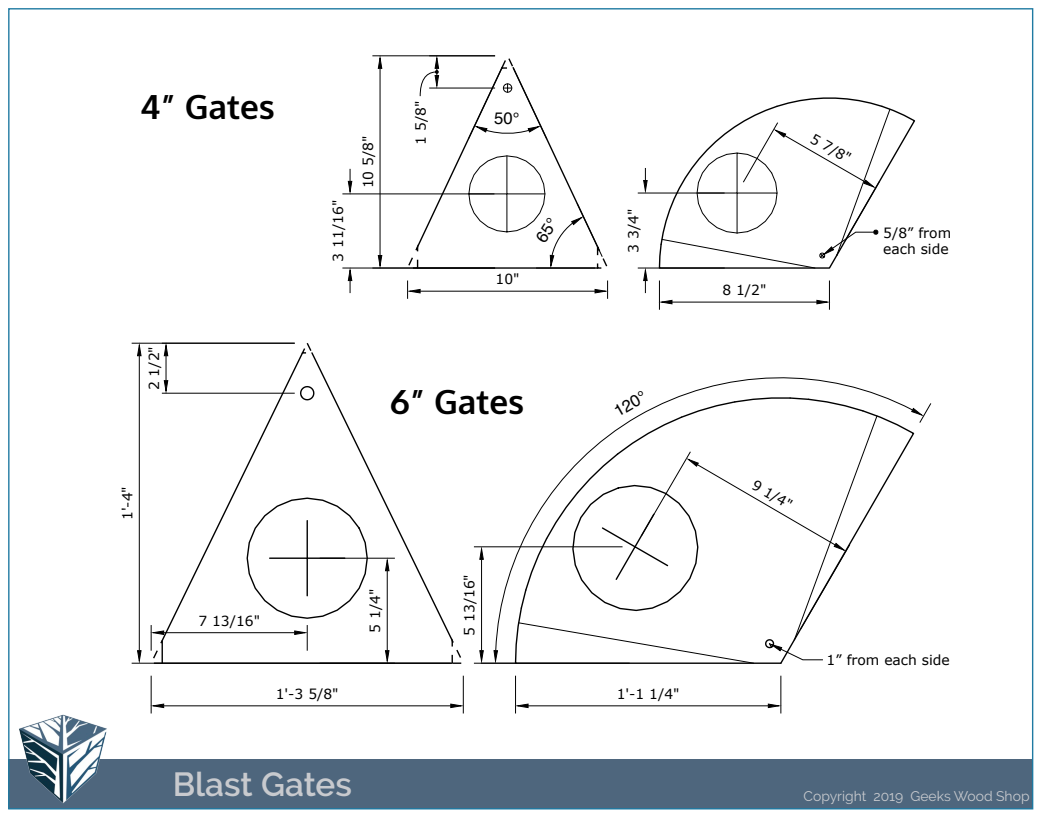
[picture p17: page 2]
Blast Gates; Copyright 2019 Geeks Wood Shop; 6” Gates; 5/8” from each side

1” from each side
