paulsilvis/DustCollector/docs/distributor.pdf

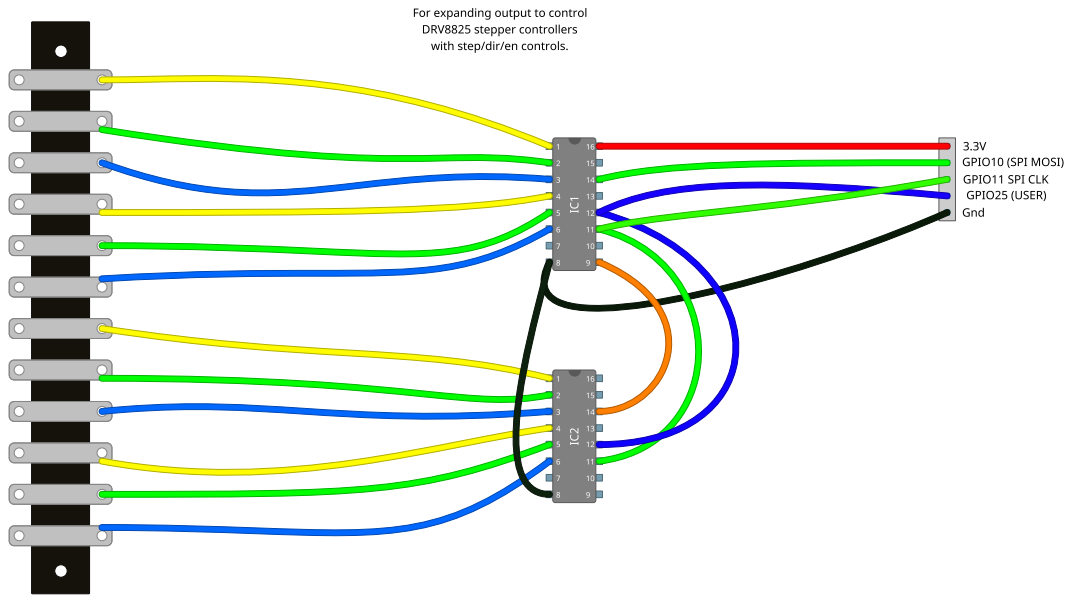
[picture p18: page 1]
