paulsilvis/DustCollector/(list of files, drawings)

Other design files:
docs/MotorDistributorSystem.fzz
