paulsilvis/DustCollector/src/usb_cam_stream.py

from flask import Flask, Response
import cv2

app = Flask(__name__)

# Capture from USB camera (usually index 0)
camera = cv2.VideoCapture(0)

def generate_frames():
    while True:
        success, frame = camera.read()
        if not success:
            break
        else:
            # Encode frame as JPEG
            _, buffer = cv2.imencode('.jpg', frame)
            frame = buffer.tobytes()
            
            # Yield frame in multipart format
            yield (b'--frame\r\n'
                   b'Content-Type: image/jpeg\r\n\r\n' + frame + b'\r\n')

@app.route('/')
def index():
    return '<h1>USB Camera Stream</h1><img src="/video">'

@app.route('/video')
def video():
    return Response(generate_frames(),
                    mimetype='multipart/x-mixed-replace; boundary=frame')

if __name__ == '__main__':
    app.run(host='0.0.0.0', port=5000)
