paulsilvis/DustCollector/src/module_template.py

"""
Module: module_name
Description: Brief summary of what this module does.
Author: Paul
"""

# Constants
MAX_RETRIES = 3
DEFAULT_TIMEOUT = 5.0

class ClassName:
    """Brief description of the class purpose."""

    def __init__(self, param1, param2):
        self.param1 = param1
        self.param2 = param2

    def method_name(self):
        """Brief description of what this method does."""
        pass

def utility_function():
    """Helper function that performs a specific task."""
    pass


# Optional: test block
if __name__ == "__main__":
    print("Module test mode.")
    # Add test code or simple demo usage
