paulsilvis/DustCollector/(commit log)

2025-04-29 all 4 motors work, #2 chip being replaced
    [8825_test.py, 8825_test_all.py, SIPO_FAST_test.py, SIPO_test.py, debug88.py, distributor.py]
2025-05-17 first real cut at parts database, still has a bug in list method.
    [partsdb.py]
2025-05-19 finally got all motors working!
2025-05-19 Add inline editing, last-used location reuse, and safe exit
    - Improved edit prompts using prompt_toolkit with default values and full cursor editing
    - Added shorthand to reuse last entered location for batch item entry
    - Handled Ctrl-C gracefully: cancel input or prompt to save on exit (with default to yes)
    - Updated delete and edit confirmations to accept Enter as default 'yes'
    [partsdb.py]
2025-06-02 major rewrite of design doc, added some helpful scripts and diagrams.
    [IOBitAssignments.ods]
2025-06-02 1. added fzz file for distributor; 2. updated design doc
    [MotorDistributorSystem.fzz]
2025-06-02 clean cut at design doc!
2025-08-25 this shit actually works now. the current sense, motor on/off, gate open/close limits, led status, air quality monitor. Fan-fucking-tastic!
